KidoTech/MicroMouse-PIC/Mechanical/B2B-PH-K-S(LF)(SN)--3DModel-STEP-56544.step

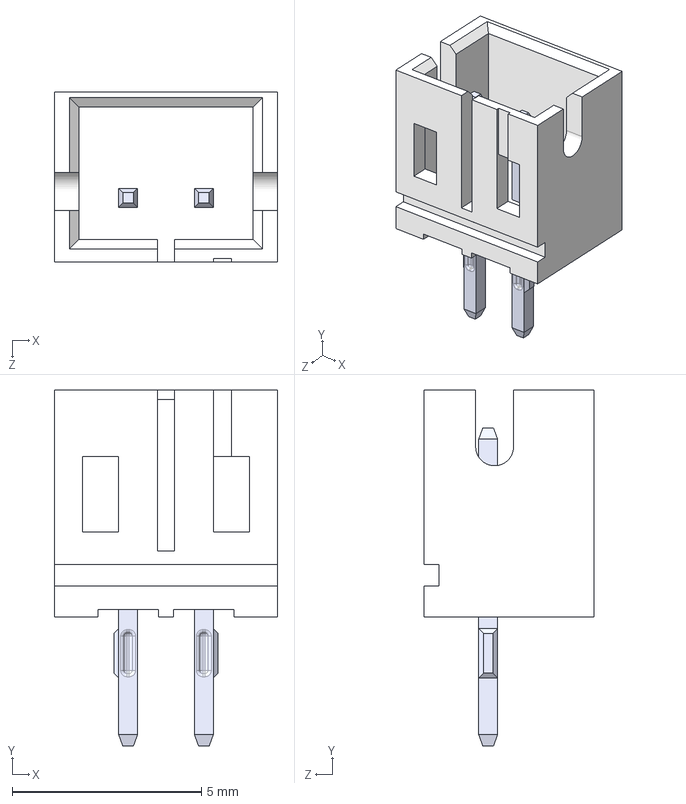
[picture p1: CAD file, 2021-06-22]
Mechanical/B2B-PH-K-S(LF)(SN)--3DModel-STEP-56544.step
5.90 x 9.40 x 4.50 mm
