KidoTech/MicroMouse-PIC/Mechanical/Pin Header 1x4 TH Pitch 2.54mm.stp

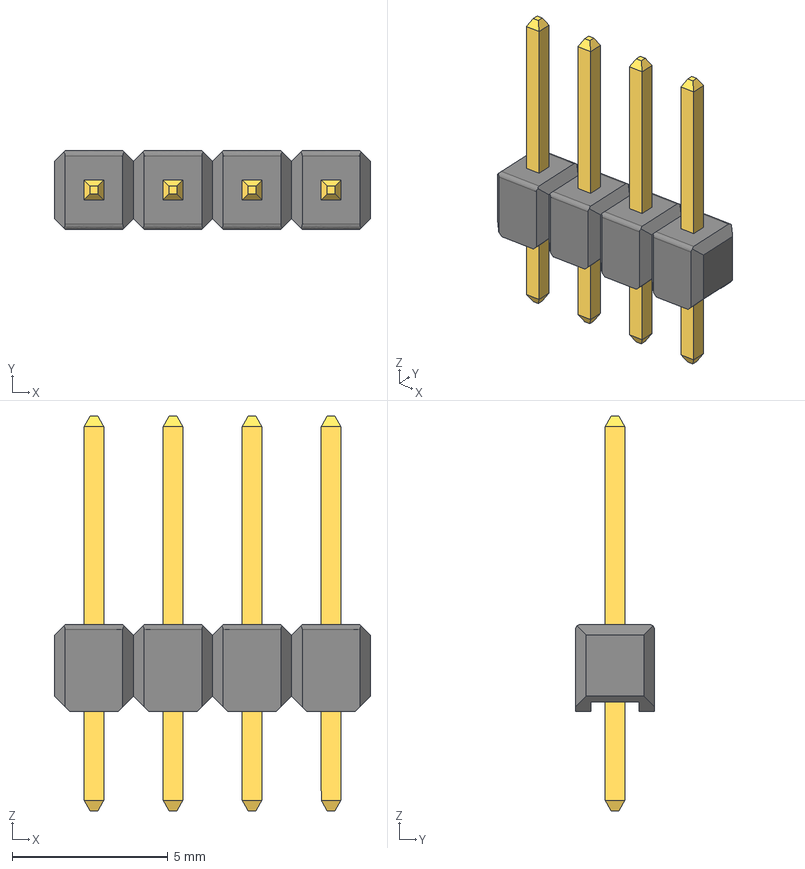
[picture p2: CAD file, 2021-06-22]
Mechanical/Pin Header 1x4 TH Pitch 2.54mm.stp
10.2 x 2.54 x 12.7 mm
