KidoTech/MicroMouse-PIC/Mechanical/R_14_ADI.step

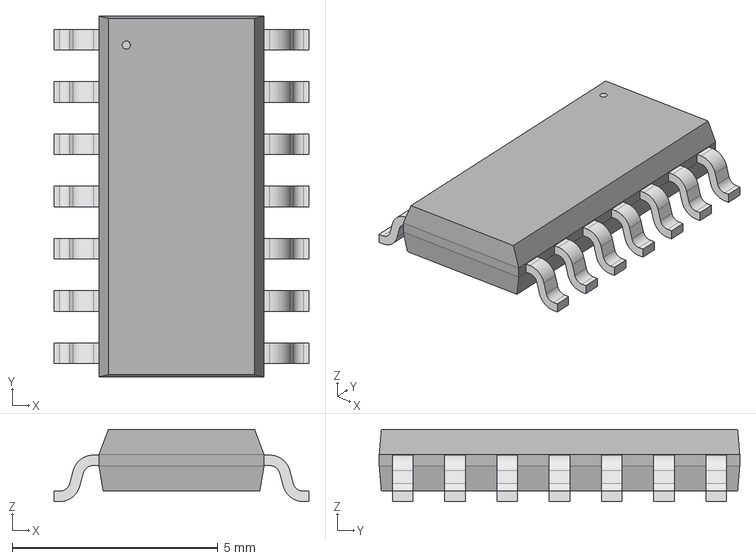
[picture p3: CAD file, 2021-04-06]
Mechanical/R_14_ADI.step
6.20 x 8.76 x 1.75 mm
