KidoTech/MicroMouse-PIC/Mechanical/TCRT1000--3DModel-STEP-1.step

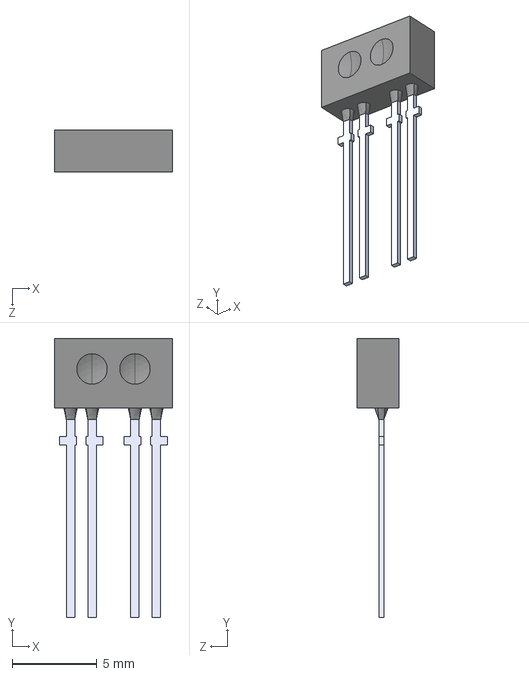
[picture p4: CAD file, 2021-04-06]
Mechanical/TCRT1000--3DModel-STEP-1.step
7.00 x 16.5 x 2.50 mm
