KidoTech/MicroMouse-PIC/Mechanical/ULN2803ADWG4.step

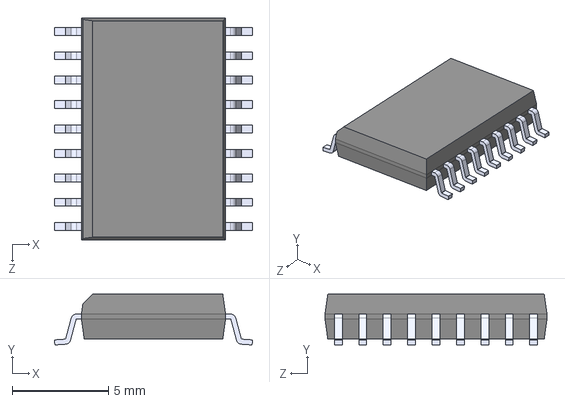
[picture p5: CAD file, 2021-04-06]
Mechanical/ULN2803ADWG4.step
10.3 x 2.65 x 11.6 mm
