KidoTech/MicroMouse-PIC/Mechanical/SOT457.step

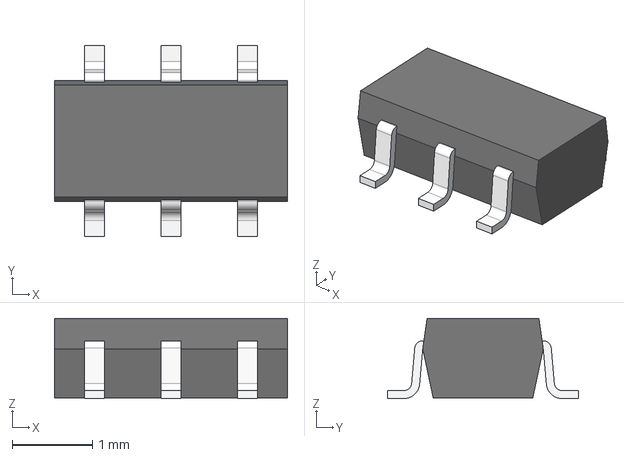
[picture p6: CAD file, 2021-04-06]
Mechanical/SOT457.step
2.90 x 2.38 x 1.00 mm
