KidoTech/MicroMouse-PIC/Mechanical/SOIC28-W_MC_MCH.step

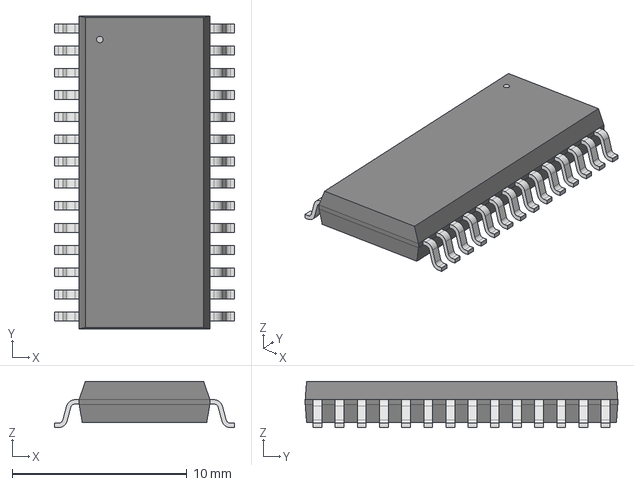
[picture p7: CAD file, 2021-04-04]
Mechanical/SOIC28-W_MC_MCH.step
10.3 x 17.9 x 2.64 mm
