KidoTech/MicroMouse-PIC/Mechanical/RM_8_ADI.step

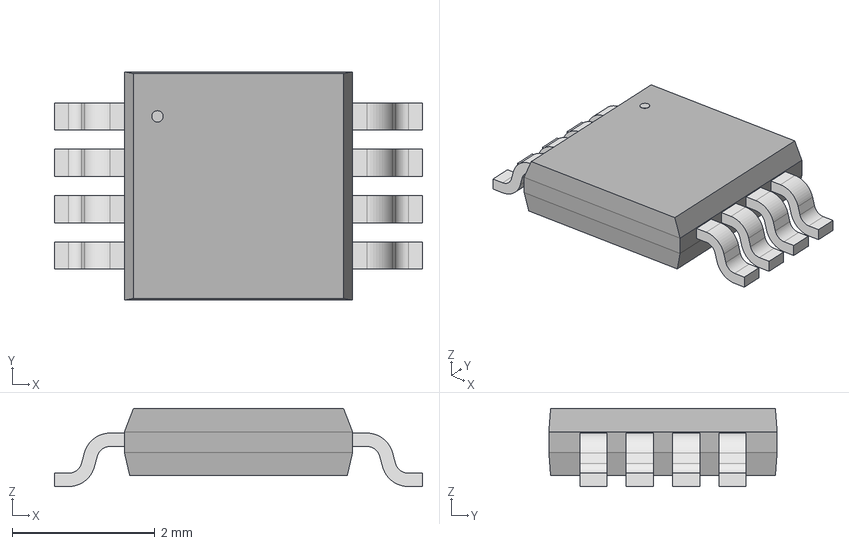
[picture p8: CAD file, 2021-04-04]
Mechanical/RM_8_ADI.step
5.16 x 3.20 x 1.09 mm
