KidoTech/MicroMouse-PIC/Mechanical/KEYELCO_1042.step

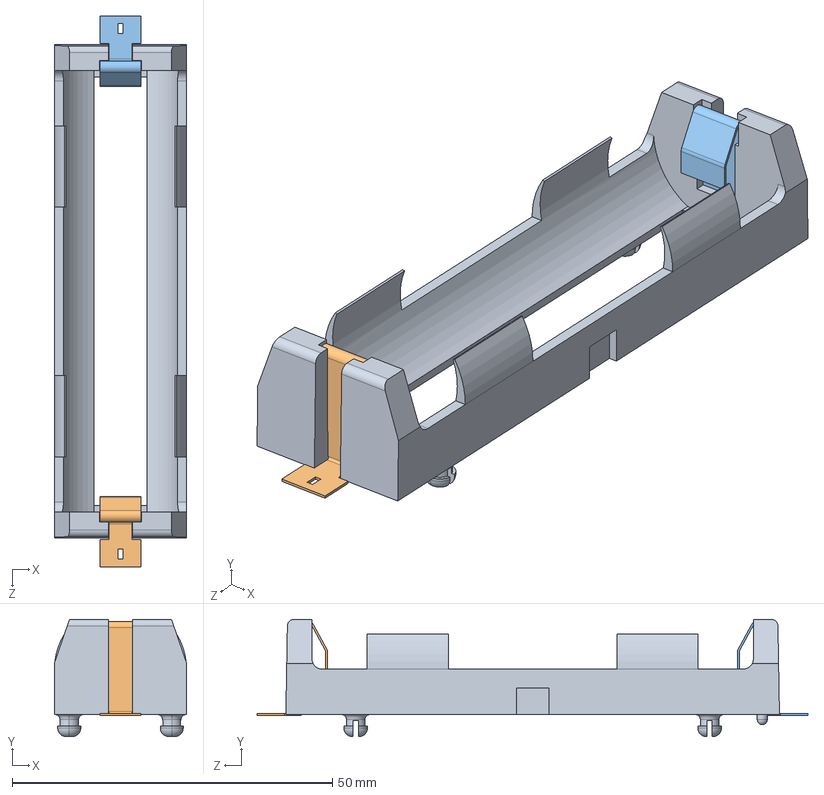
[picture p9: CAD file, 2021-04-04]
Mechanical/KEYELCO_1042.step
20.7 x 18.3 x 86.0 mm
