KidoTech/MicroMouse-PIC/Mechanical/THRU-254-STR-6P.stp

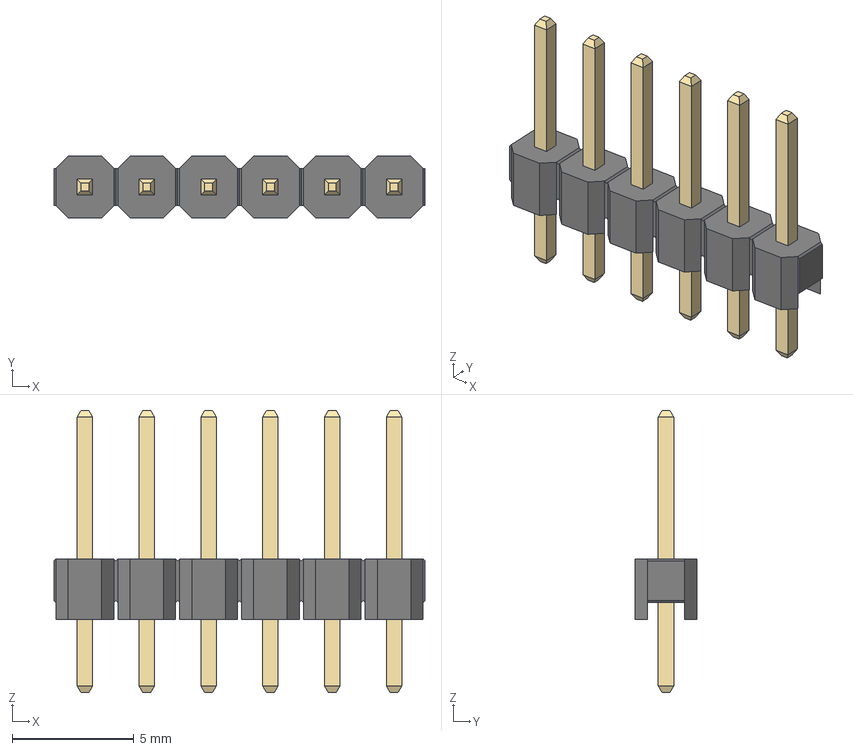
[picture p10: CAD file, 2021-04-04]
Mechanical/THRU-254-STR-6P.stp
15.2 x 2.54 x 11.6 mm
