KidoTech/MicroMouse-PIC/Mechanical/SON4_PTS526SM15SMTR2LFS_CNK.step

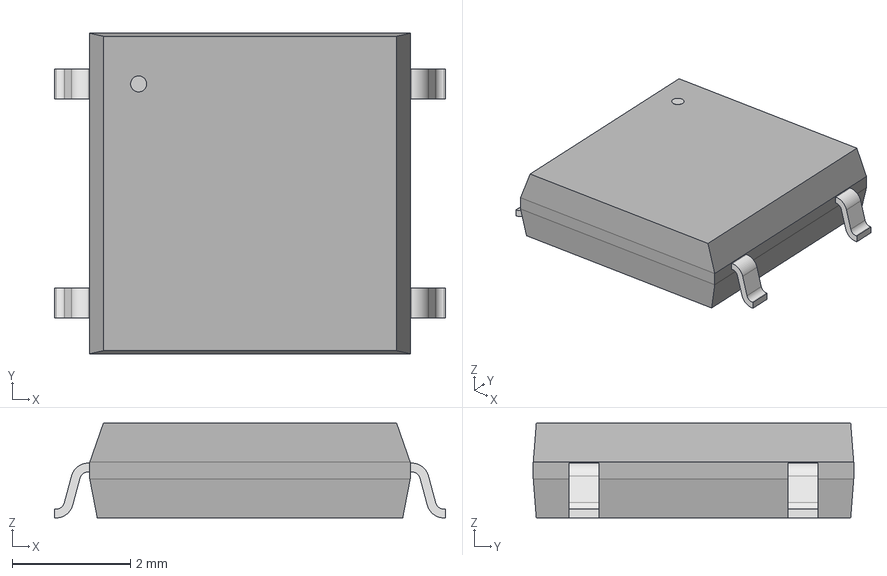
[picture p11: CAD file, 2021-04-04]
Mechanical/SON4_PTS526SM15SMTR2LFS_CNK.step
6.60 x 5.41 x 1.60 mm
