KidoTech/MicroMouse-PIC/Mechanical/ECS-.327-12.5-1210-TR.STEP

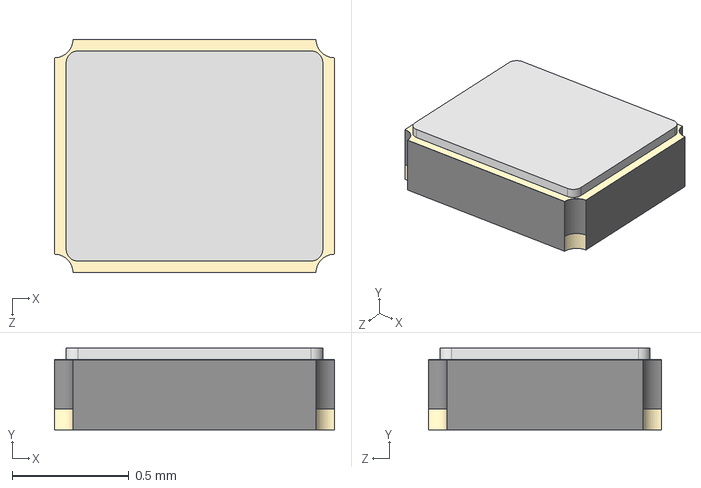
[picture p12: CAD file, 2021-04-04]
Mechanical/ECS-.327-12.5-1210-TR.STEP
1.20 x 0.35 x 1.00 mm
