KidoTech/MicroMouse-PIC/Mechanical/B5B-XH-A.STEP

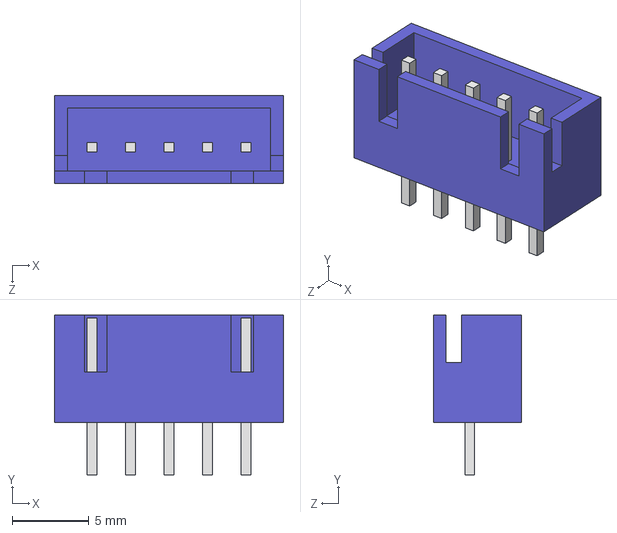
[picture p13: CAD file, 2021-04-04]
Mechanical/B5B-XH-A.STEP
14.9 x 10.4 x 5.75 mm
