KidoTech/MicroMouse-PIC/Mechanical/CAP0805.stp

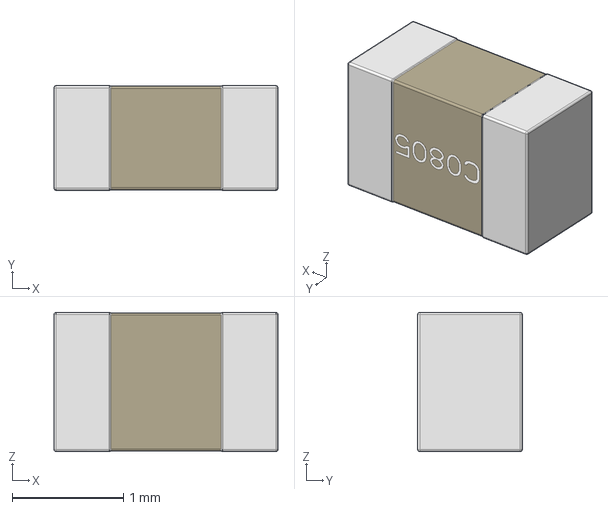
[picture p14: CAD file, 2021-04-04]
Mechanical/CAP0805.stp
2.01 x 0.94 x 1.25 mm
