KidoTech/MicroMouse-PIC/Mechanical/SZMMSZ9-SOD123.step

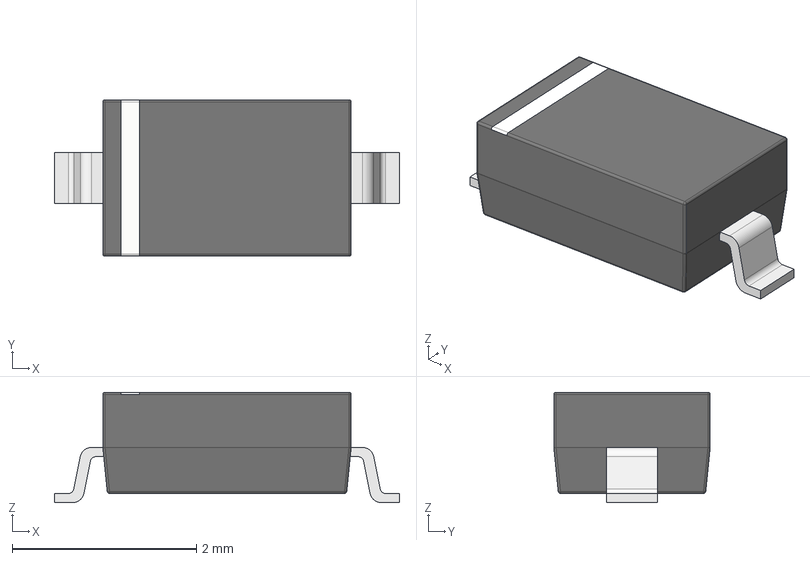
[picture p15: CAD file, 2021-04-04]
Mechanical/SZMMSZ9-SOD123.step
3.75 x 1.70 x 1.20 mm
pin
pin(Mirror)
icbody
