KidoTech/MicroMouse-PIC/Mechanical/SOT23-3.stp

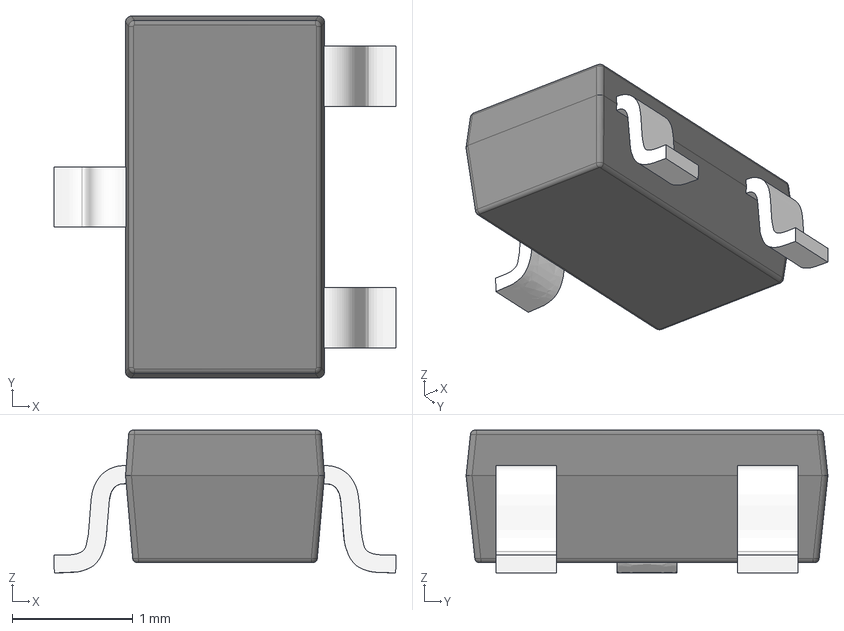
[picture p16: CAD file, 2021-04-04]
Mechanical/SOT23-3.stp
2.84 x 3.00 x 1.18 mm
