KidoTech/MicroMouse-PIC/Mechanical/MBRA210-SMA.stp

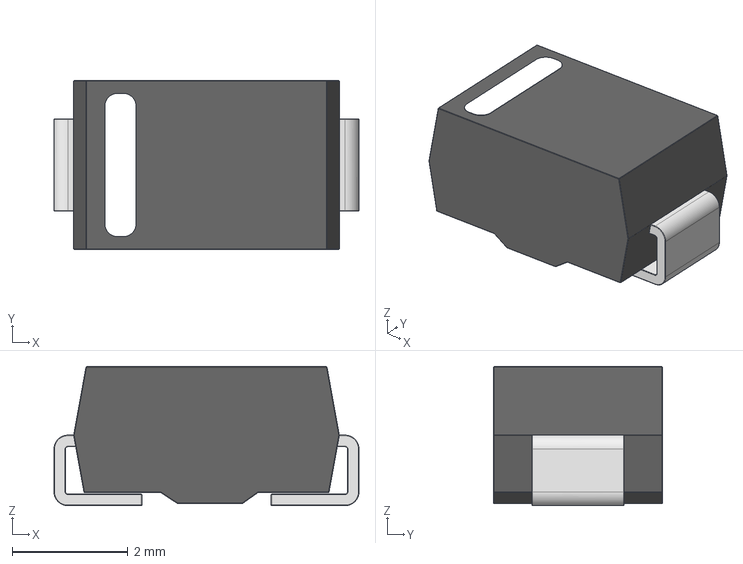
[picture p17: CAD file, 2021-04-04]
Mechanical/MBRA210-SMA.stp
5.28 x 2.92 x 2.41 mm
