KidoTech/MicroMouse-PIC/Mechanical/THRU-254-RHT-6P.stp

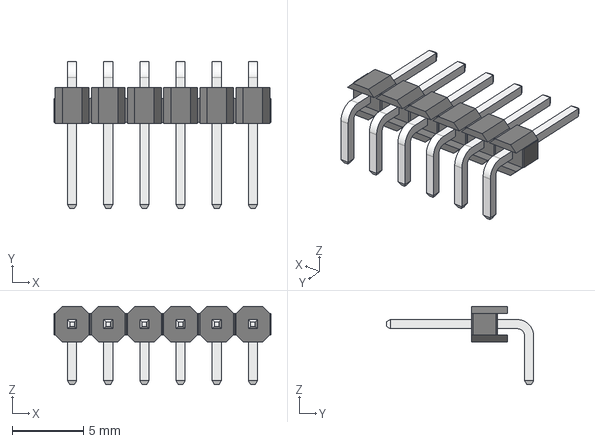
[picture p18: CAD file, 2021-04-04]
Mechanical/THRU-254-RHT-6P.stp
15.2 x 10.4 x 5.50 mm
