KidoTech/MicroMouse-PIC/Mechanical/CAP0603.stp

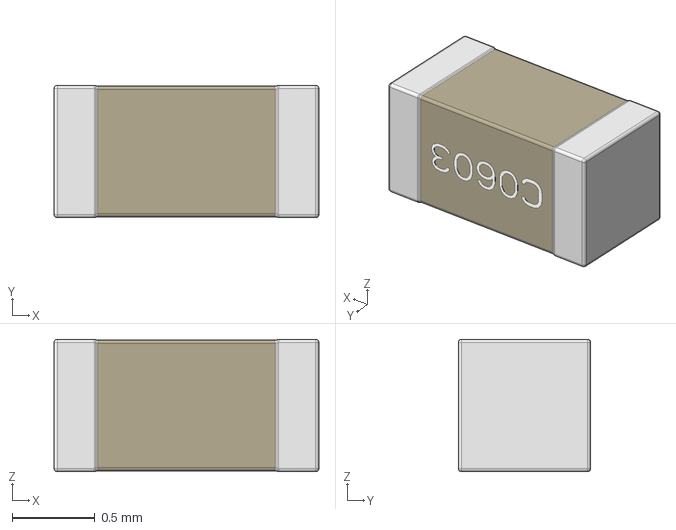
[picture p19: CAD file, 2021-04-04]
Mechanical/CAP0603.stp
1.60 x 0.8 x 0.8 mm
