KidoTech/MicroMouse-PIC/Mechanical/RES0603.stp

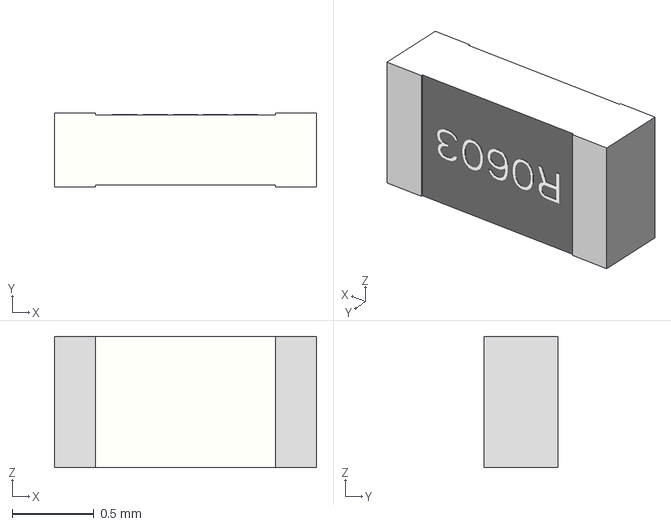
[picture p20: CAD file, 2021-04-04]
Mechanical/RES0603.stp
1.60 x 0.45 x 0.8 mm
