KidoTech/MicroMouse-PIC/Mechanical/FER0603.step

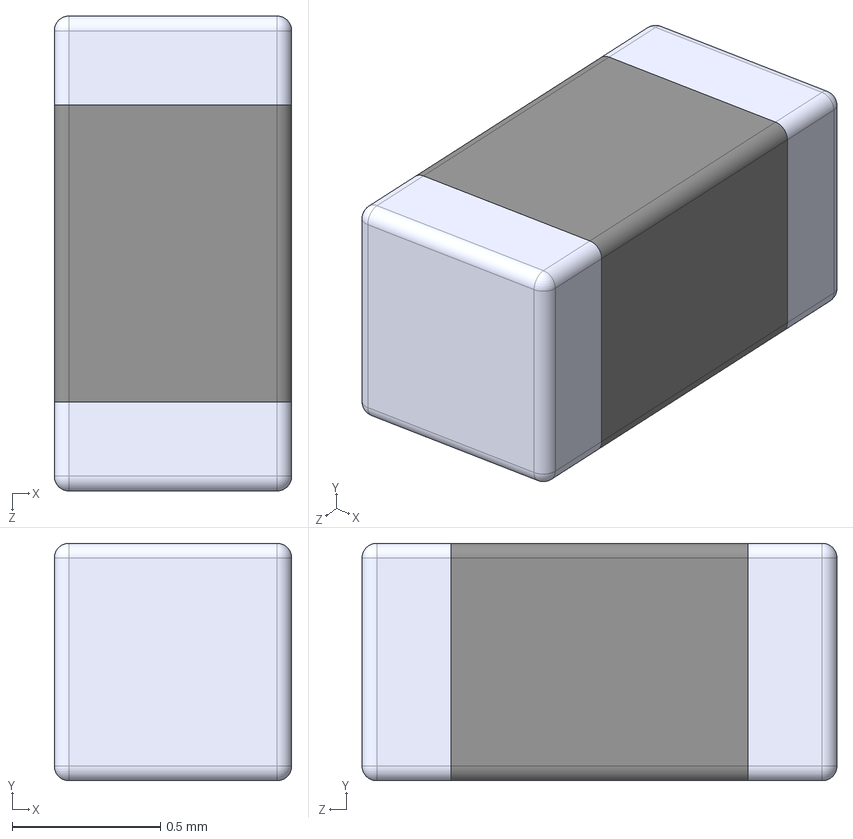
[picture p21: CAD file, 2021-04-04]
Mechanical/FER0603.step
0.8 x 0.8 x 1.60 mm
