KidoTech/MicroMouse-PIC/Mechanical/LED0805.STEP

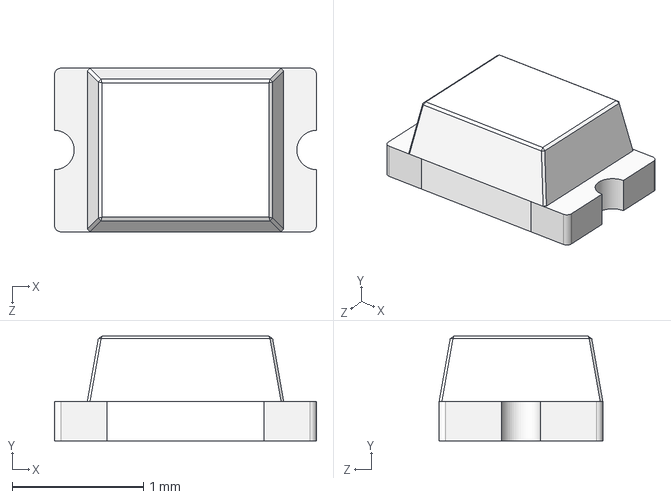
[picture p22: CAD file, 2021-04-04]
Mechanical/LED0805.STEP
2.00 x 0.8 x 1.25 mm
