KidoTech/MicroMouse-PIC/Mechanical/CAP0402.stp

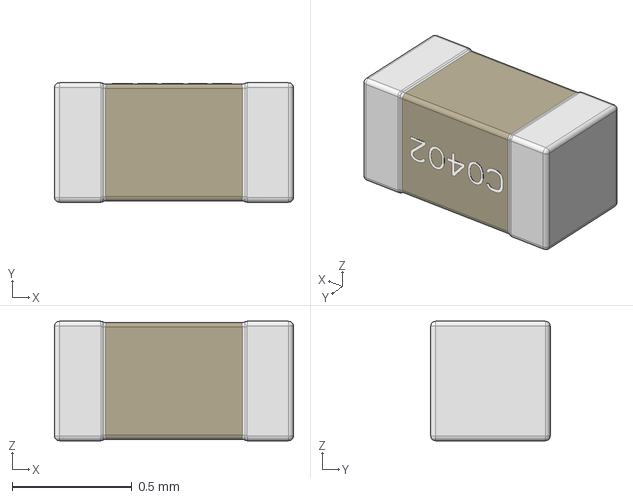
[picture p23: CAD file, 2021-04-04]
Mechanical/CAP0402.stp
1.00 x 0.5 x 0.5 mm
