KidoTech/MicroMouse-PIC/(list of files, cad)

Other CAD files:
Mechanical/3306K001.stp
Mechanical/744878001.stp
Mechanical/L101011MS02Q.step
