KidoTech/MicroMouse-PIC/Hardware/MicroMouse-PIC16F886-SCH-REV1_10.pdf

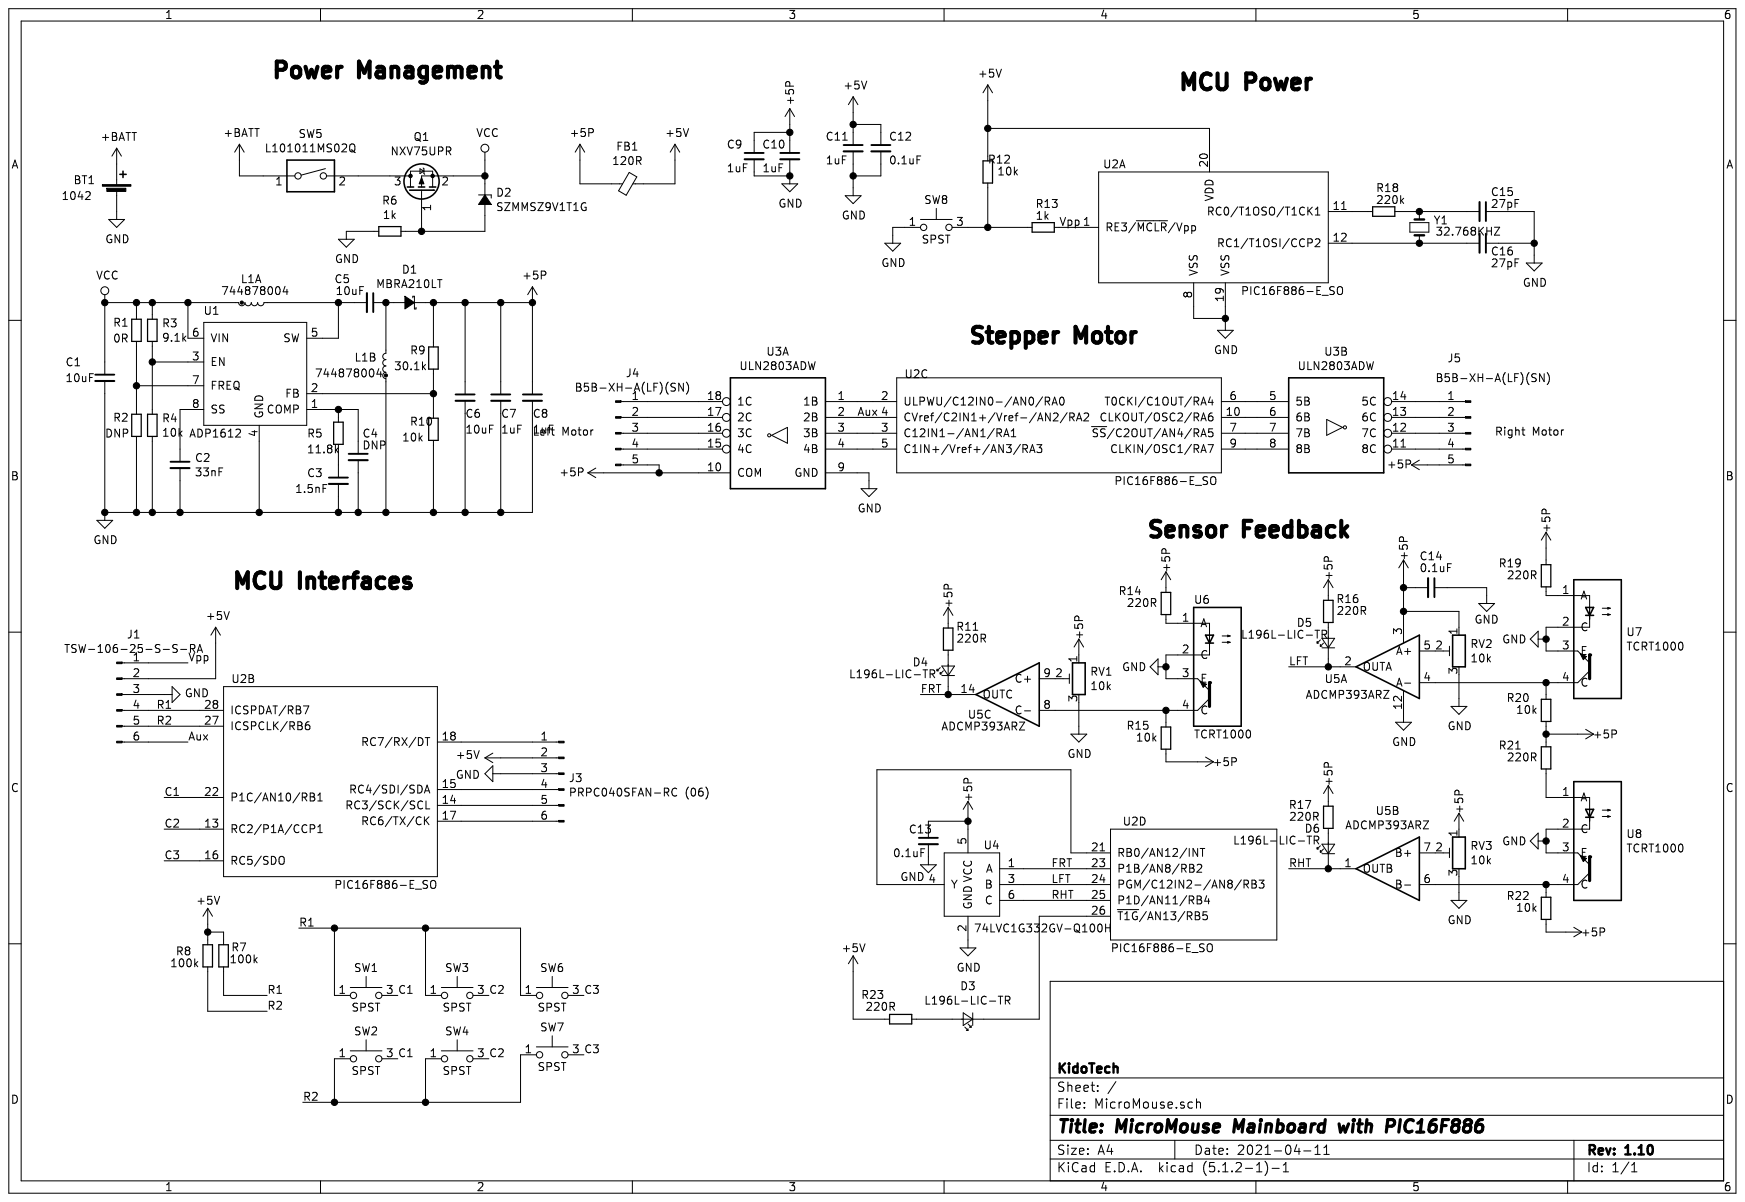
[picture p24: page 1]
