KidoTech/MicroMouse-PIC/Hardware/MicroMouse.kicad_pcb

## KiCad design Hardware/MicroMouse.kicad_pcb (2022-01-05)

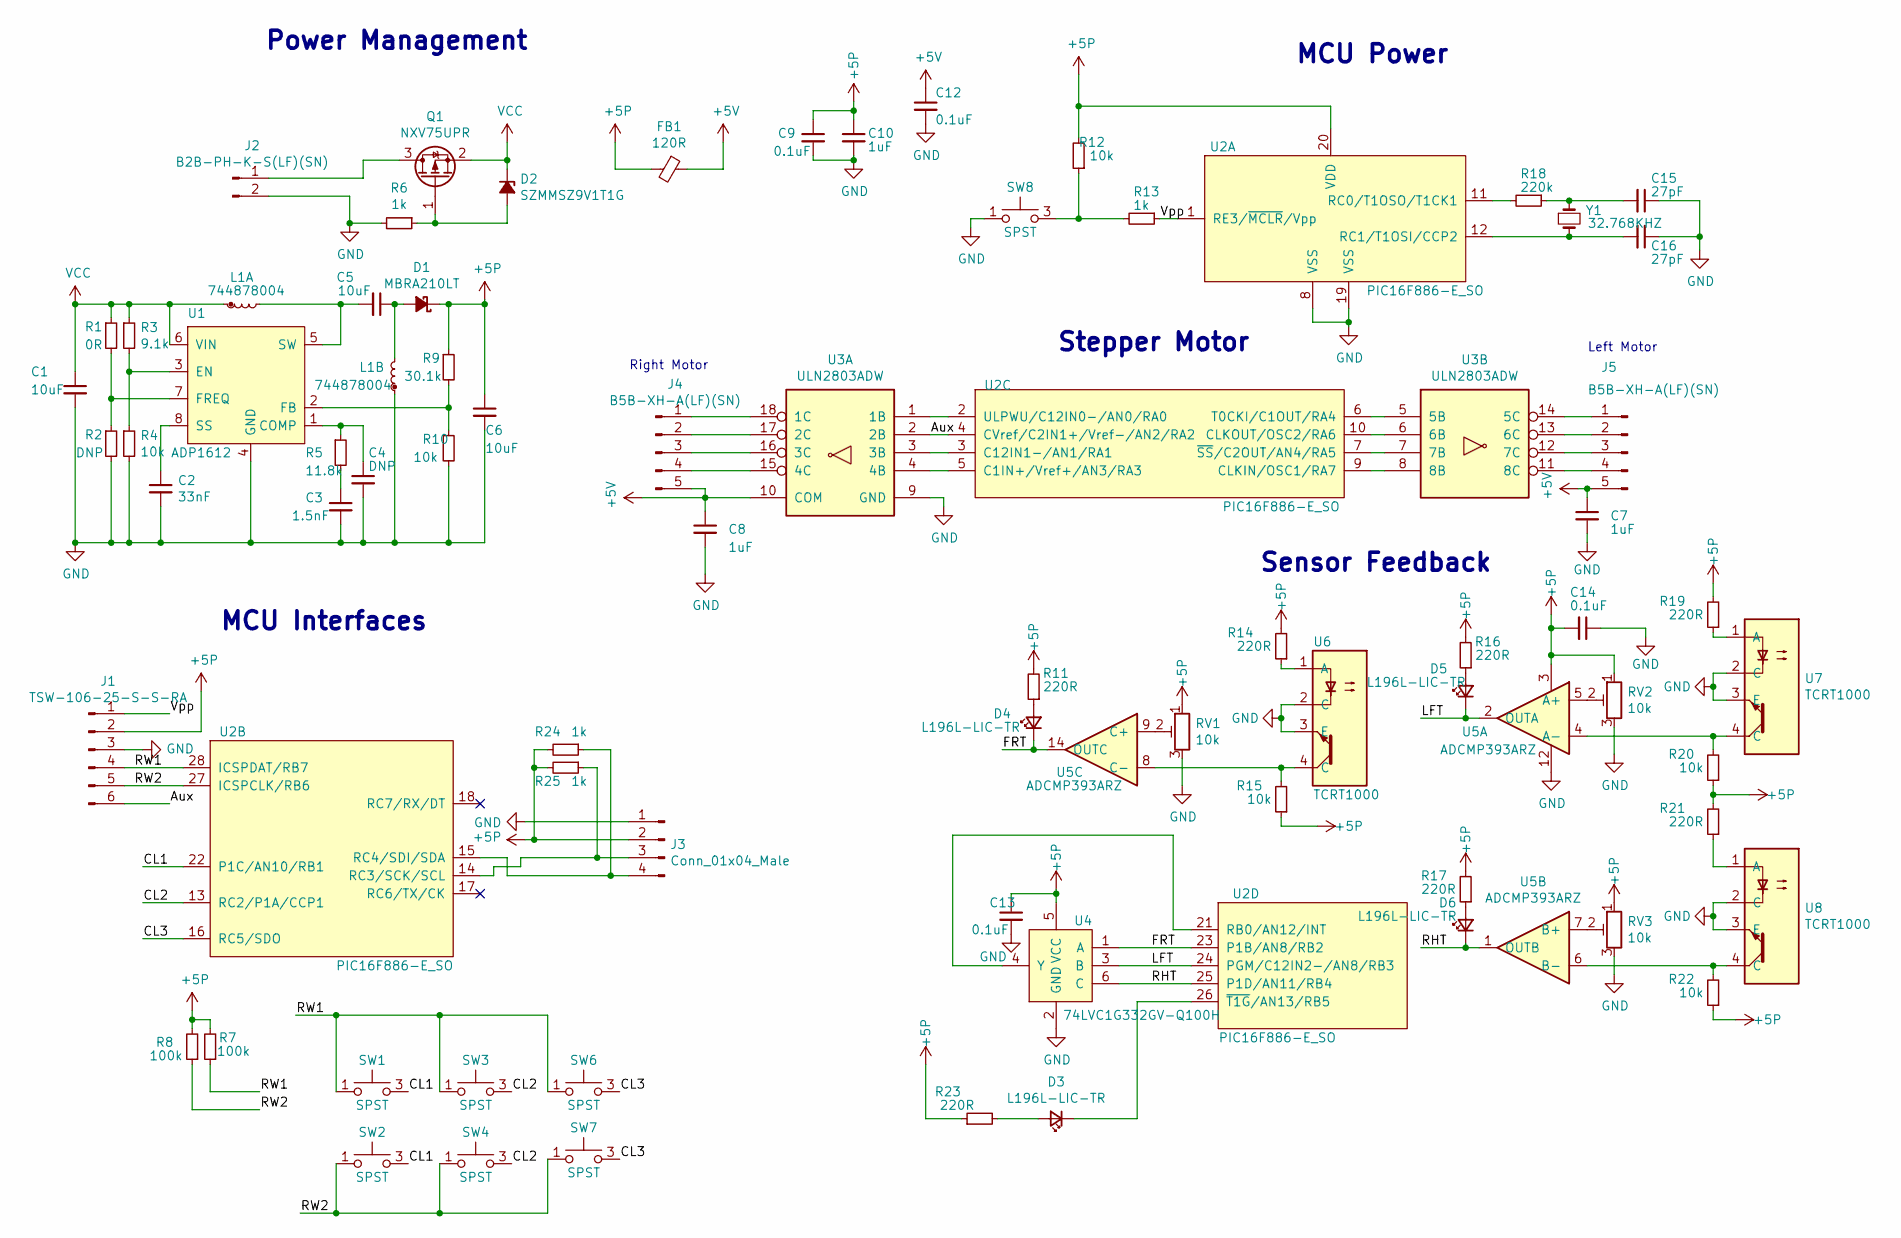
[picture p25: schematic MicroMouse.sch, MicroMouse Mainboard with PIC16F886]

Parts:
C1, C5, C6: 10uF; CAP0805
C2: 33nF; CAP0603
C3: 1.5nF; CAP0603
C4: DNP; CAP0603
C7, C8, C10: 1uF; CAP0603
C9, C12, C13, C14: 0.1uF; CAP0603
C15, C16: 27pF; CAP0603
D1: MBRA210LT; MBRA210-SMA
D2: SZMMSZ9V1T1G; SZMMSZ9-SOD123
D3, D4, D5, D6: L196L-LIC-TR; LTST-C170-0805
FB1: 120R; FER0603
J1: TSW-106-25-S-S-RA; THRU-254-RHT-6P
J2: B2B-PH-K-S(LF)(SN); THRU-200-STR-2P
J3: Conn_01x04_Male; THRU-254-STR-4P
J4, J5: B5B-XH-A(LF)(SN); THRU-250-STR-5P
L1: 744878004; 744878004-SMD
Q1: NXV75UPR; NXV75UPR-SOT233
R1: 0R; RES0603
R2: DNP; RES0603
R3: 9.1k; RES0603
R4, R10, R12, R15, R20, R22: 10k; RES0603
R5: 11.8k; RES0603
R6, R13, R24, R25: 1k; RES0603
R7, R8: 100k; RES0603
R9: 30.1k; RES0603
R11, R14, R16, R17, R19, R21, R23: 220R; RES0603
R18: 220k; RES0603
RV1, RV2, RV3: 10k; 3306K-THRU
SW1, SW2, SW3, SW4, SW6, SW7, SW8: SPST; PTS526-4SMD
U1: ADP1612; ADP1612-8MSOP
U2: PIC16F886-E_SO; PIC16F886-28SOIC
U3: ULN2803ADW; ULN2803A-18SO
U4: 74LVC1G332GV-Q100H; 74LVC1G332-6TSOP
U5: ADCMP393ARZ; ADCMP393-14SOIC
U6, U7, U8: TCRT1000; TCRT1000-THRU
Y1: 32.768KHZ; ECX1210-2SMD

Connections:
+5P: C6.1, C9.1, C10.1, C13.1, C14.2, D1.1 (K), FB1.2, J1.2, J3.2, R7.2, R8.2, R9.1, R11.2, R12.2, R14.2, R15.1, R16.2, R17.2, R19.2, R20.1, R21.2, R22.1, R23.1, R24.2, R25.2, RV1.1, RV2.1, RV3.1, U2.20 (VDD), U4.5 (VCC), U5.3
+5V: C7.1, C8.1, C12.1, FB1.1, J4.5, J5.5, U3.10 (COM)
/Aux: J1.6, U2.4 (CVref/C2IN1+/Vref-/AN2/RA2), U3.2 (2B)
/CL1: SW1.3 (B), SW1.4 (B), SW2.3 (B), SW2.4 (B), U2.22 (P1C/AN10/RB1)
/CL2: SW3.3 (B), SW3.4 (B), SW4.3 (B), SW4.4 (B), U2.13 (RC2/P1A/CCP1)
/CL3: SW6.3 (B), SW6.4 (B), SW7.3 (B), SW7.4 (B), U2.16 (RC5/SDO)
/FRT: D4.1 (K), U2.23 (P1B/AN8/RB2), U4.1 (A), U5.14 (OUTC)
/LFT: D5.1 (K), U2.24 (PGM/C12IN2-/AN8/RB3), U4.3 (B), U5.2 (OUTA)
/RHT: D6.1 (K), U2.25 (P1D/AN11/RB4), U4.6 (C), U5.1 (OUTB)
/RW1: J1.4, R7.1, SW1.1 (A), SW1.2 (A), SW3.1 (A), SW3.2 (A), SW6.1 (A), SW6.2 (A), U2.28 (ICSPDAT/RB7)
/RW2: J1.5, R8.1, SW2.1 (A), SW2.2 (A), SW4.1 (A), SW4.2 (A), SW7.1 (A), SW7.2 (A), U2.27 (ICSPCLK/RB6)
/Vpp: J1.1, R13.1, U2.1 (RE3/~MCLR~/Vpp)
GND: C1.2, C2.2, C3.2, C4.2, C6.2, C7.2, C8.2, C9.2, C10.2, C12.2, C13.2, C14.1, C15.1, C16.1, J1.3, J2.2, J3.1, L1.4, R2.2, R4.2, R6.2, R10.2, RV1.3, RV2.3, RV3.3, SW8.1 (A), SW8.2 (A), U1.4 (GND), U2.8 (VSS), U2.19 (VSS), U3.9 (GND), U4.2 (GND), U5.12, U6.2 (C), U6.3 (E), U7.2 (C), U7.3 (E), U8.2 (C), U8.3 (E)
unnamed: C2.1, U1.8 (SS)
unnamed: C3.1, R5.2
unnamed: C4.1, R5.1, U1.1 (COMP)
unnamed: C5.1, D1.2 (A), L1.3
unnamed: C5.2, L1.2, U1.5 (SW)
unnamed: C15.2, R18.1, Y1.1
unnamed: C16.2, U2.12 (RC1/T1OSI/CCP2), Y1.2
unnamed: D2.2 (A), Q1.1 (G), R6.1
unnamed: D3.1 (K), U2.26 (~T1G~/AN13/RB5)
unnamed: D3.2 (A), R23.2
unnamed: D4.2 (A), R11.1
unnamed: D5.2 (A), R16.1
unnamed: D6.2 (A), R17.1
unnamed: J2.1, Q1.3 (D)
unnamed: J3.3, R25.1, U2.14 (RC3/SCK/SCL)
unnamed: J3.4, R24.1, U2.15 (RC4/SDI/SDA)
unnamed: J4.1, U3.18 (1C)
unnamed: J4.2, U3.17 (2C)
unnamed: J4.3, U3.16 (3C)
unnamed: J4.4, U3.15 (4C)
unnamed: J5.1, U3.14 (5C)
unnamed: J5.2, U3.13 (6C)
unnamed: J5.3, U3.12 (7C)
unnamed: J5.4, U3.11 (8C)
unnamed: R1.2, R2.1, U1.7 (FREQ)
unnamed: R3.2, R4.1, U1.3 (EN)
unnamed: R9.2, R10.1, U1.2 (FB)
unnamed: R12.1, R13.2, SW8.3 (B), SW8.4 (B)
unnamed: R14.1, U6.1 (A)
unnamed: R15.2, U5.8 (C-), U6.4 (C)
unnamed: R18.2, U2.11 (RC0/T1OSO/T1CK1)
unnamed: R19.1, U7.1 (A)
unnamed: R20.2, U5.4 (A-), U7.4 (C)
unnamed: R21.1, U8.1 (A)
unnamed: R22.2, U5.6 (B-), U8.4 (C)
unnamed: RV1.2, U5.9 (C+)
unnamed: RV2.2, U5.5 (A+)
unnamed: RV3.2, U5.7 (B+)
unnamed: U2.2 (ULPWU/C12IN0-/AN0/RA0), U3.1 (1B)
unnamed: U2.3 (C12IN1-/AN1/RA1), U3.3 (3B)
unnamed: U2.5 (C1IN+/Vref+/AN3/RA3), U3.4 (4B)
unnamed: U2.6 (T0CKI/C1OUT/RA4), U3.5 (5B)
unnamed: U2.7 (~SS~/C2OUT/AN4/RA5), U3.7 (7B)
unnamed: U2.9 (CLKIN/OSC1/RA7), U3.8 (8B)
unnamed: U2.10 (CLKOUT/OSC2/RA6), U3.6 (6B)
unnamed: U2.21 (RB0/AN12/INT), U4.4 (Y)
VCC: C1.1, D2.1 (K), L1.1, Q1.2 (S), R1.1, R3.1, U1.6 (VIN)

Notes on the sheet:
Power Management
MCU Power
MCU Interfaces
Stepper Motor
Left Motor
Right Motor
Sensor Feedback

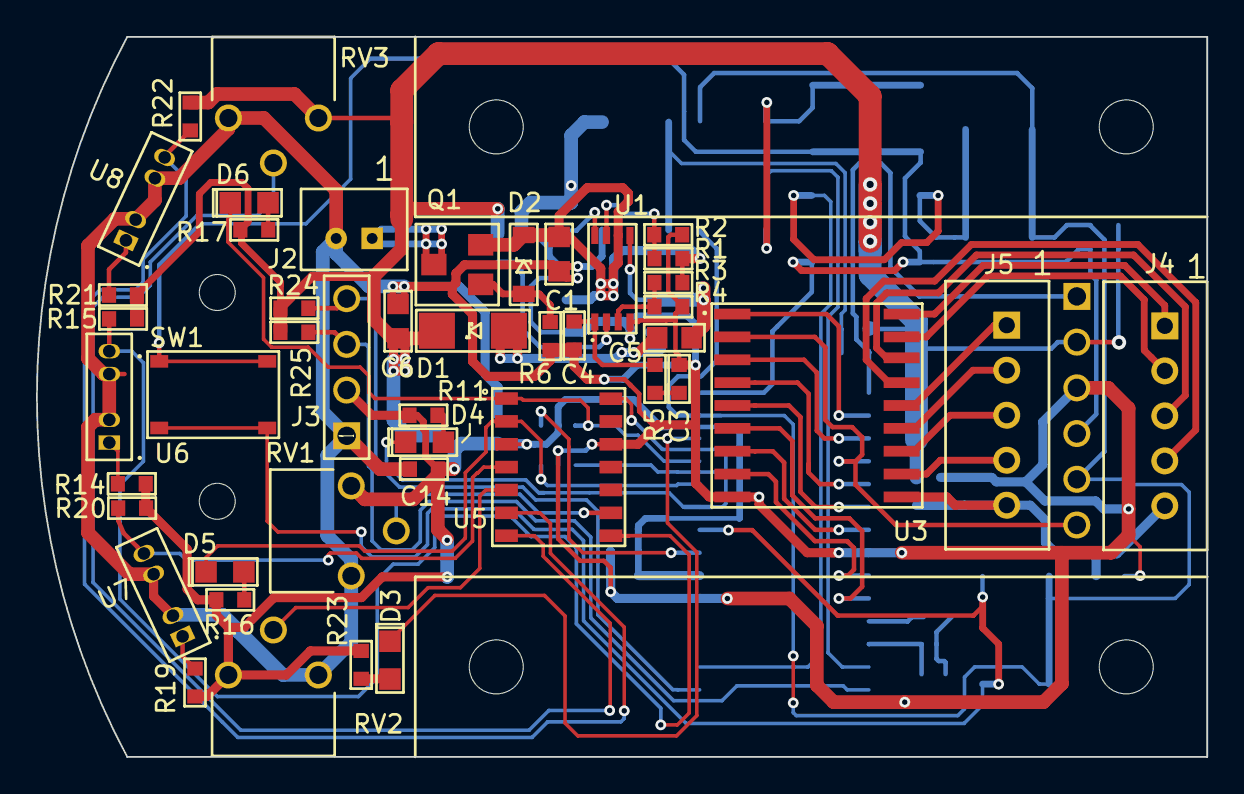
[picture p26: board MicroMouse.kicad_pcb from above]

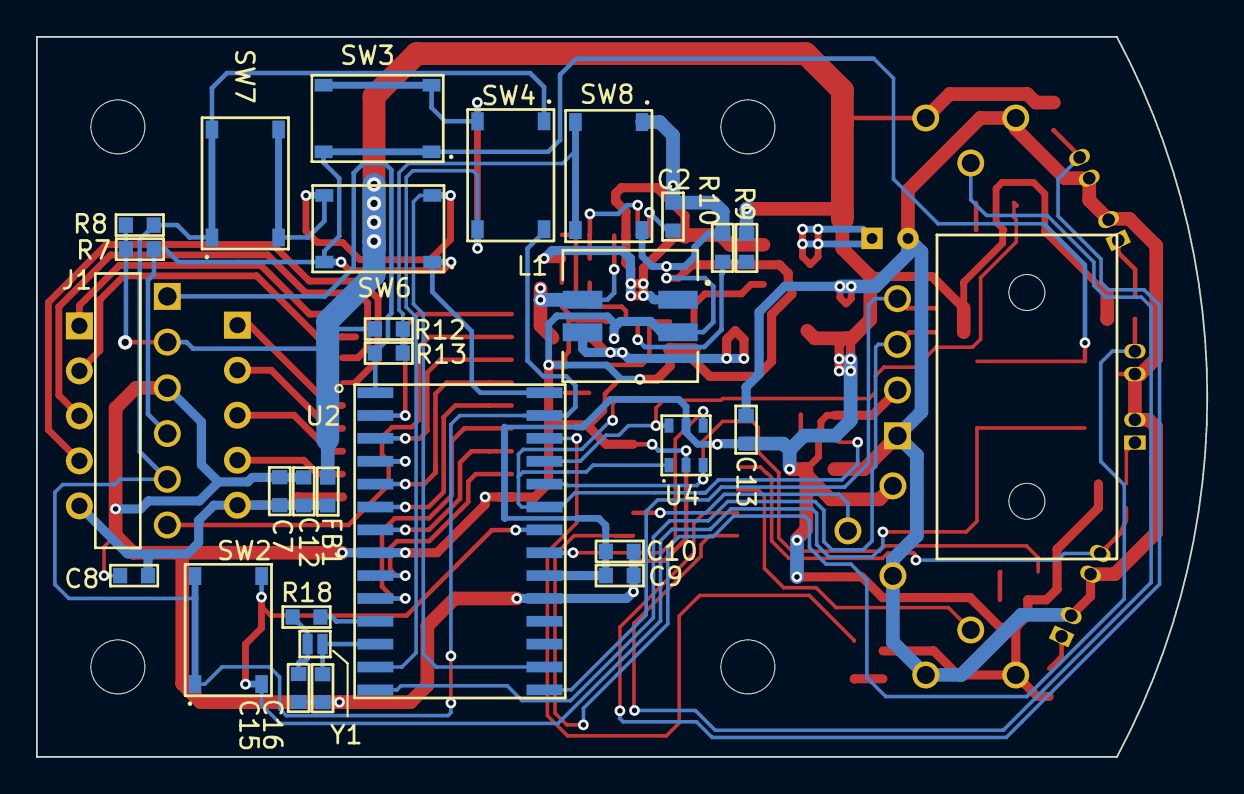
[picture p27: board MicroMouse.kicad_pcb from below]

Board: 2 copper layers, 65.0 x 40.0 mm, 73 parts (28 on the bottom side), 60 nets.
