KidoTech/MicroMouse-PIC/(commit log)

2021-04-02 Update design
    [MicroMouse.sch, Stepper_28BYJ-48.stp]
2021-04-03 Create BOM
    [MicroMouse.csv, MicroMouse.sch]
2021-04-03 Add battery holder and add matrix button
    [MicroMouse.sch]
2021-04-03 Add BOM
2021-04-04 Create new foot print
    [3306K001.stp, 744878001.stp, CAP0402.stp, CAP0603.stp, CAP0805.stp, FER0603.step, LED0805.STEP, MBRA210-SMA.stp]
2021-04-04 Add new footprint
    [B5B-XH-A.STEP, ECS-.327-12.5-1210-TR.STEP, KEYELCO_1042.step, L101011MS02Q.step, RM_8_ADI.step, SOIC28-W_MC_MCH.step, SON4_PTS526SM15SMTR2LFS_CNK.step, THRU-254-STR-6P.stp]
2021-04-06 Add footprint to project
    [MicroMouse.sch, R_14_ADI.step, SOT457.step, TCRT1000--3DModel-STEP-1.step, ULN2803ADWG4.step]
2021-04-11 Generate Schematic PDF
2021-04-11 Add LED for IR detection
    [MicroMouse.sch]
2021-06-20 Update Layout
    [MicroMouse.sch, Robot-Base.dxf]
2021-06-24 Layout Update
    [MicroMouse.kicad_pcb]
2022-01-05 Generate Gerber files
    [MicroMouse-B_Cu.gbr, MicroMouse-B_Mask.gbr, MicroMouse-B_Paste.gbr, MicroMouse-B_SilkS.gbr, MicroMouse-Edge_Cuts.gbr, MicroMouse-F_Cu.gbr, MicroMouse-F_Mask.gbr, MicroMouse-F_Paste.gbr]
